EpsilonZero885/2023-CCNY-AIAA-Flight-Sensor-Array/(commit log)

2023-02-25 Added SPI to lib_deps in the platformio.ini file to resolve dependency issues
2023-02-25 Added more description to samplescript for MPX5010DP. Copied Global Variables and Functions from samplescript for MPX5010DP to the main script. Added data column and renumbered columns in main script
2023-02-25 Modified README.txt to incorporate part list, pinout, version 8 notes, and resource links for MPX5010DP sensor
2023-02-26 Made pwm mapping variables global, changed type from int to int8_t. Verify that this does not cause output issues before merging.
    [main.cpp]
2023-02-28 Modified README to reflect results of testing while using independent power supplies for the Sensor+arduino and the Receiver+Motors
2023-02-28 Updated README part list to include servo motors
2023-03-02 Added a tiny switch to the powerboost ENA pin, updated README to reflect this update
2023-03-18 Removed peripheral code, file pathers were becoming too long. Possibly include later?
    [main.cpp]
2023-03-30 Added Weights for the servos, need a better scale to measure the complete sensor rray
2023-04-27 Major changes to main.cpp to correct error and offset in airSpeedMPX5010DP() function
    [main.cpp]
